dkouidis/Oven-Control-Monitoring-System-Aristurlte/Aristurtle_Oven.pdf

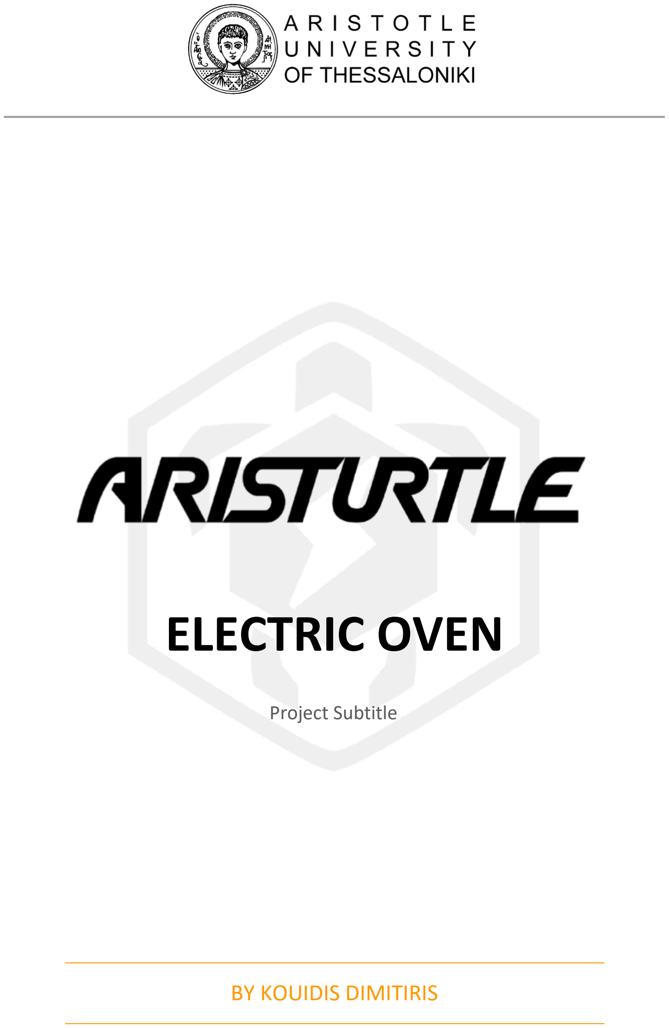
[picture p1: page 1]

# ELECTRIC OVEN

Project Subtitle

### BY KOUIDIS DIMITIRIS

Page 2 of 23

### Table of Contents

Table of Contents | 2
Introduction | 3
1. | HARDWARE | 4
| 1.1 Zero-Volt Cross Detection Circuitry | 4
| 1.2 Phase Control | 6
| 1.3 Temperature Reading | 7
| 1.4 Hall sensor | 7
2. | Peripherals | 8
| 2.1 LCD Display | 8
| 2.2 Thermocouples | 8
| 2.3 Potentiometer | 8
| 2.4 Digital Temperature Sensors | 8
| 2.5 Safety Digital Temperature Sensor | 9
3. | Control System | 10
| 3.1 Brief to PI control | 10
| 3.2 Esp32 | 11
4.Temporary implementation | 12
5. Test and suggestions | 22
Sources – References | 23

Page 3 of 23

## Introduction

This year we decided to re-manufacture the external electric oven that operates with a PI control in combination with a phase control system. This decision was made after noticing that the previous system could not keep the temperature close to the desired one and the declinations during the function of the oven were large, while the mechanical team was not able to use the smaller oven located on the Oikiskos B for everything they needed.

To provide a solution to this problem, we reconstructed the oven from scratch, we designed a new PCB using a better version of the Zero Cross Detection circuitry and added some extra safety features.

This booklet’s purpose is to explain the basic functions of the electric oven, providing explanations of the circuits used in the PCB, the software used and the
improvements that can be made.

By the time this booklet is being written, there is no software implementation for the actual PCB but software for a “version” of it as the time was limited and we implement a faster, maybe not so reliable, solution. The booklet contains both the current implementation and the “correct” one.

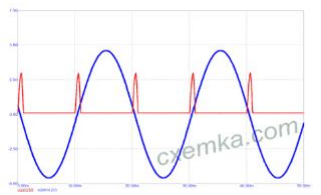
[picture p2: figure]
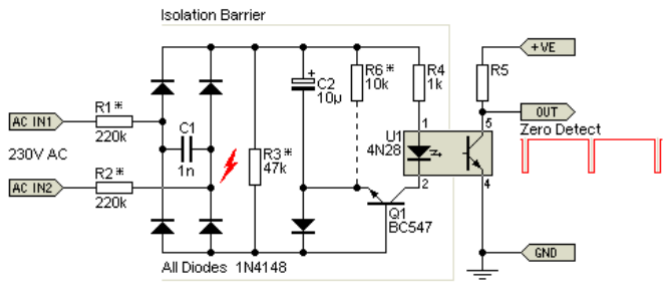
[picture p3: figure]

Page 4 of 23

## 1. HARDWARE

1.1 Zero-Volt Cross Detection Circuitry

As shown on the image below, we want to detect the times that the alternating voltage passes the 0V point and each time it does send a signal/pulse to our microcontroller. With blue we represent the alternating voltage and with red the pulses.

To achieve this, we needed to find a circuit that does this exact thing, while degrading the voltage from 220V to a value much smaller.

Page 5 of 23

The above circuit was found online and tested before deciding whether to use it or not. During the tests we noticed that the results were satisfactory and better than the previous implementation for the detections of the zero cross.

You can find the analytical description of the circuitry in the Sources-References chapter on links [5] and [6].

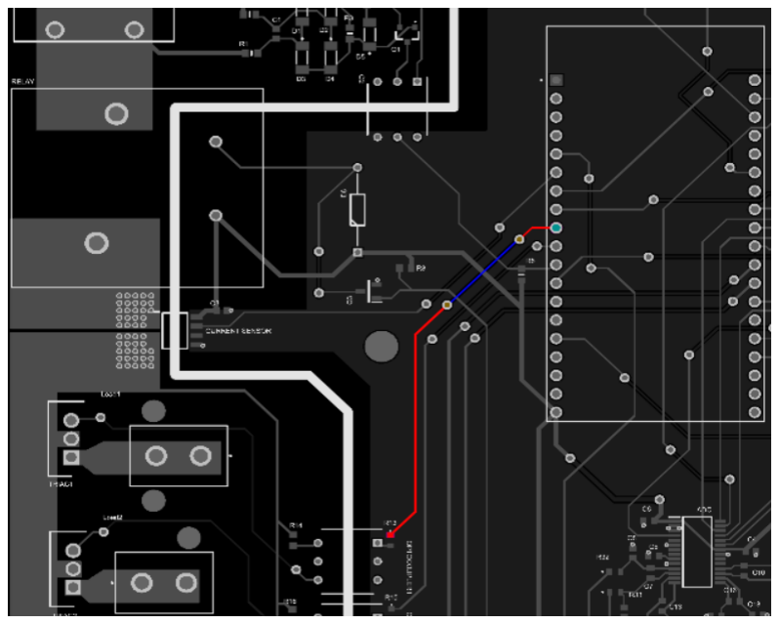
[picture p4: figure]
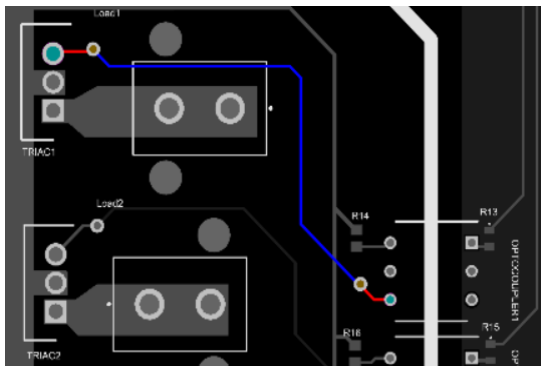
[picture p5: figure]

Page 6 of 23

1.2 Phase Control

After the zero-volt cross detection the pi controller, implemented with the esp32, decides when the firing pulse will be sent. To achieve the desired load, we use four optocouplers, so we need four firing pulses. The firing pulses are being sent by some pins of the esp32. Each of these pins are connected to an optocoupler. We need the optocoupler for isolation between the esp32 and the triacs. The outlet of each optocoupler is connected with the trigger gate of one triac and in that way the triac receives the triggering pulse of the esp32, and it conducts.

Page 7 of 23

1.3 Temperature Reading

In addition to the improvement of the zero-volt cross detection circuit, we decided to improve the measurement of the oven’s internal temperature by using four thermocouples. To read their values we use an ADC compatible with the SPI protocol. Each thermocouple is placed on one of the edges of the oven and with the ADC we alternate the readings between them every few milliseconds. By that way we can calculate the average temperature of the four thermocouples and have a clear view of the setup’s function

1.4 Hall sensor

For safety reasons we decided to add a Hall sensor to measure the current flowing through the triacs. The sensor sends the measurement to esp32 and can be printed on the Serial Monitor or shown on the LCD Display, according to your preferences.

Page 8 of 23

## 2. Peripherals

2.1 LCD Display
As a display we used a 16×2 LCD display that interfaces with I2C protocol. On the LCD we display the current temperature and the target. The LCD holds four pins, one for 5V, one for ground (GND) and two for communication. These are the SDA and SCL pins which need to be connected to 21 and 22 pins of the esp32 respectively.

2.2 Thermocouples
A thermocouple is an electrical device consisting of two dissimilar electrical conductors (https://en.wikipedia.org/wiki/Electrical_conductor) forming an electrical junction. (https://en.wikipedia.org/wiki/Electrical_junction) A thermocouple produces a temperature dependent voltage (https://en.wikipedia.org/wiki/Voltage) as a result of the Seebeck effect, (https://en.wikipedia.org/wiki/Seebeck_effect) and this voltage can be interpreted to measure temperature. (https://en.wikipedia.org/wiki/Temperature) We use four thermocouples each connected to the ADC.

2.3 Potentiometer
The potentiometer is used to set the desired temperature for the oven to avoid having to change the value in the code and upload it every time a change is needed.

2.4 Digital Temperature Sensors
Apart from the thermocouples the setup supports up to four digital temperature sensors in order to verify the measurements that we get from the thermocouples. Each sensor has its own mini-PCB (which contains also a capacitor) to facilitate the connection with the main PCB. The sensors support the SPI protocol so we can alternate the readings between them and the ADC.

Notice that there is a code implementation with a digital sensor, the code of which you can find in the team’s Gitlab on the unity “Little Oven”.

Page 9 of 23

2.5 Safety Digital Temperature Sensor
Another programmable temperature sensor is being used for safety reasons. If the temperature of the oven exceeds a certain large value (in case of malfunction) it triggers a Normally Open relay and it stops the power supply of the triacs. The sensor has its own mini-PCB (which includes three resistors and a capacitor) as well.

Page 10 of 23

## 3. Control System

3.1 Brief to PI control

A proportional–integral controller (PI controller) is a control loop mechanism employing feedback that is widely used in industrial control systems and a variety of other applications requiring continuously modulated control. A PI controller continuously calculates an error value e(t) as the difference between a desired setpoint and a measured process variable and applies a correction based on proportional and integral terms (denoted P and I respectively).

→ Term P is proportional to the error e(t). For example, if the error is large and positive, the control output will be proportionately large and positive, considering the gain factor "K". Using proportional control alone will result in an error between the setpoint and the actual process value, because it requires an error to generate the proportional response. If there is no error, there is no corrective response.

→ Term I accounts for past values of the error and integrates them over time to produce the I term. For example, if there is a residual error after the application of proportional control, the integral term seeks to eliminate the residual error by adding a control effect due to the historic cumulative value of the error. When the error is eliminated, the integral term will cease to grow. This will result in the proportional effect diminishing as the error decreases, but this is compensated for by the growing integral effect.

Tuning

The balance of these effects is achieved by loop tuning to produce the optimal control function. The tuning constants are shown below as "K" and must be derived for each control application, as they depend on the response characteristics of the complete loop external to the controller. These are dependent on the behavior of the measuring sensor, the final control element, any control signal delays and the process itself.

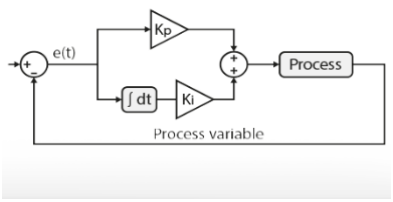
[picture p6: figure]

Page 11 of 23

Notice that for the further improvement of the setup, a Term D (derivative) can be added to the control (PID controller).

3.2 Esp32
We used an esp32-devkitC to implement PI control and the interface with the user. The last one includes the LCD display and the potentiometer.

The basic functions of the esp32 are:

- Read the desired temperature through the potentiometer
- Read the temperature through the ADC
- Read the current value through the hall sensor
- Detect the zero-volt cross
- Execute PI control to reach the desired temperature
- Print the real, the desired temperature and the error to the display

Page 12 of 23

## 4.Temporary implementation

As mentioned at the beginning the code for all the above functionalities is non-existent. Below is described the existing code which the team used during the 2024-2025 season.

💢Thermistor

The thermistor we use is an NTC thermistor with a nominal resistance of 100kΩ. Thermistors are temperature-sensing elements made of semiconductor material that has been sintered to display large changes in resistance in proportion to small changes in temperature. This resistance can be measured by using a small and measured direct current, or dc, passed through the thermistor to measure the voltage drop produced. NTC Thermistors are non-linear resistors, which alter their resistance characteristics with temperature. The resistance of NTC will decrease as the temperature increases. The way the resistance decreases is related to a constant known in the electronics industry as beta, or β. Beta is measured in °K.

Before we convert the resistance of the thermistor to the respective temperature, we need to measure its resistance. For this purpose, we must turn the esp32 into an ohmmeter. First, we connected a resistor in series with the thermistor. This resistor should have the same resistance as the nominal resistance of the thermistor for better accuracy. This addition occurred under the connectors which would be used, under normal circumstances, for the external digital temperature sensors. We also added a decoupling capacitor for noise reduction.

So, we needed to define the resistor we used in series with the thermistor, the nominal resistance of the thermistor, the reference temperature and the b coefficient of our thermistor. We also initialize some other variables for the calculation of the temperature.

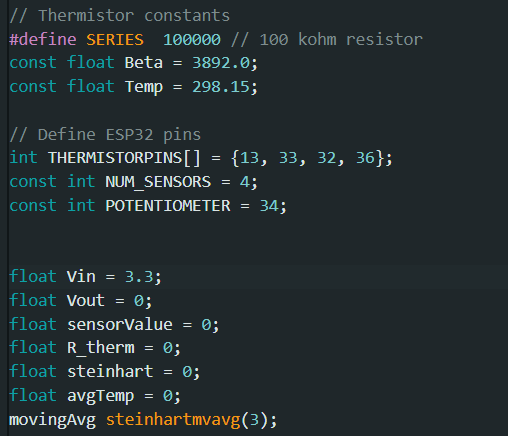
[picture p7: figure]

Page 13 of 23

The calculation of the temperature is implemented inside the function read_average_temperature(). The first step is to read the analog value from the pins of the esp32 that the thermistors are connected to and convert it to volts. Provided that we know the voltage on the thermistor, the Vin and the resistor in series with the thermistor we can calculate their resistance. At the end we calculate the average temperature.

During operation we noticed that sometimes the values from the first 2 pins were correct while 2 were not. That happened probably from some bad connections to the wire because after a point everything worked properly. However, we implemented a “check” for the values of the last 2 pins according to the measurements of the first 2. If the decline of the values is less than a threshold they are being considered, if there is more, then they are skipped.

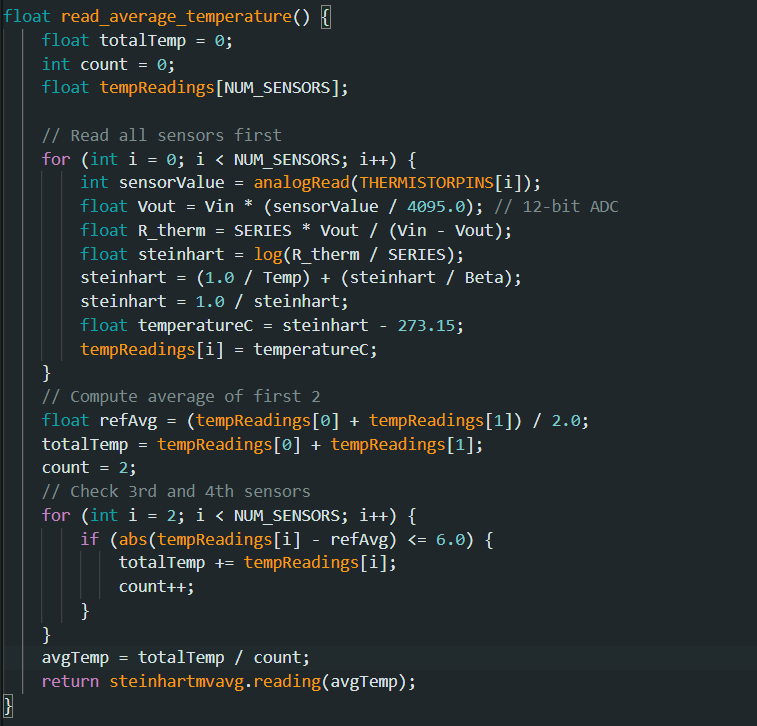
[picture p8: figure]

Page 14 of 23

💢 Zero-Volt Cross

At the beginning we define the pin where the output from the zero-volt cross detection circuit will be written and the pins which will “send” the pulse to the optocouplers. We also define a boolean value which turns to “1” when a zero-volt cross is detected to help us handle the interrupt we are using for this purpose.

Page 15 of 23

Below is provided the interrupt handler. In other words when the zcd pin goes to LOW (according to our circuit zcd is always HIGH and is pulled down when a zero cross is detected) and the error is bigger than zero then we allow the pulses from the angleControl pins to be sent to the optocouplers so that the triacs will conduct. We will explain this in more detail below.

💢 PI implementation

Continuing from the ZCD, let’s see how we handle PI control. Firstly, we declare the values of the variables used to calculate the PI output at each state. The PI output (variable “pi”) is the value which determines for how long the angleControl pins will be set as HIGH --> how many amperes will conduct through the triacs. To calculate its value, we use the formula pi = error * Kp + previous_error * Ki as can be seen below.

After manual testing, we found that Kp = 200 and Ki = 20 will give the best results for our implementation.

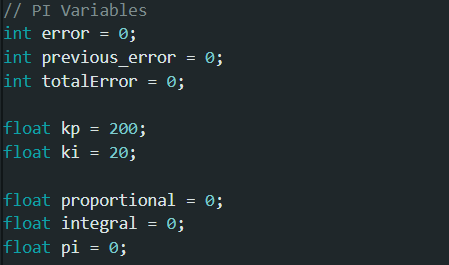
[picture p9: figure]
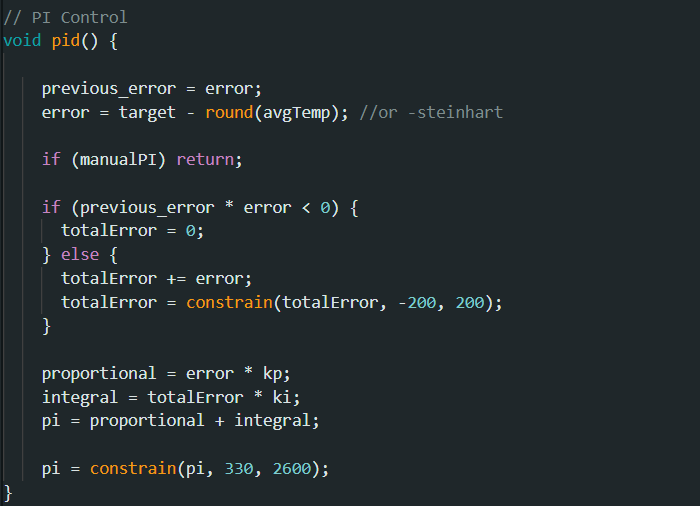
[picture p10: figure]

Page 16 of 23

To not burn the triacs, we must set constraints on the pi variable. In the PCB placed on Oikiskos B at this time, there were problems with two of the four triacs and they didn’t conduct. After hours of debugging, we could not find what was wrong. So, we supplied the four resistors from the two triacs. Having a maximum rating of 10A, after manual testing, we found out that the upper limit of pi must be 2600. Under normal circumstances and if all triacs are working properly this upper limit can be exceeded, while there is no limitation for the lower boundary. We strongly recommend that before setting the upper limit to manually test with an amperemeter the load and slightly increase it.

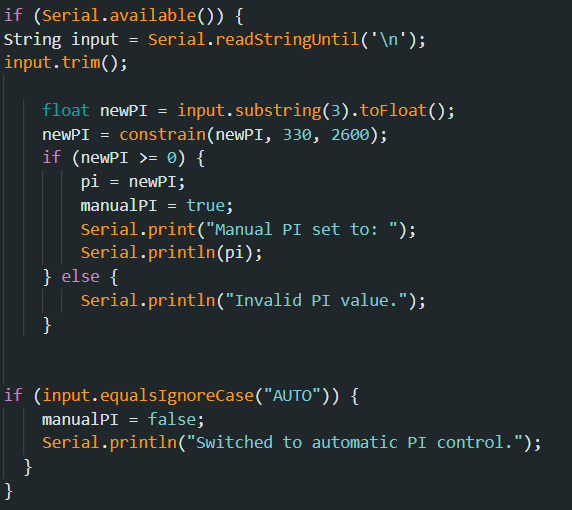
[picture p11: figure]

Page 17 of 23

To gradually increase the upper boundary, we have implemented a feature where you can change manually the PI output by writing on the Serial Monitor “PI= “and the value you want to set.

To switch back to the automatic PI control just type “AUTO”.

Below you can see how we enable the conduction of the triacs. The delay of 9700-pi us means that when the pi variable is big (== the error is big), the delay will be shorter so the triacs will conduct for a larger duration of the voltage half-cycle.

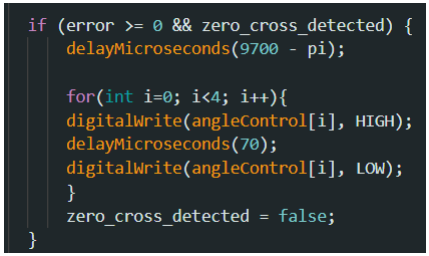
[picture p12: figure]
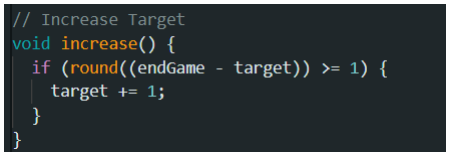
[picture p13: figure]

Page 18 of 23

💢 Target and endGame variables

The target variable starts from the value “10” and increases every 1.5 seconds until it reaches the value of endGame. That happens so the error is gradually increased, and the system follows a ramp approach.

The endGame value represents the desired temperature we want to achieve inside the oven.

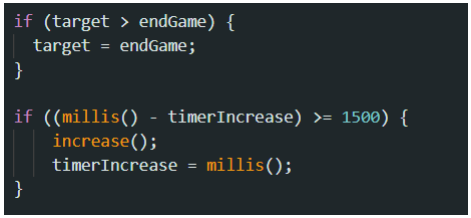
[picture p14: figure]

Page 19 of 23

💢 LCD display

The LCD displays the current and the desirable temperature, the target value as it increases and the error value. The code we use to achieve that is implemented inside the function monitor() which is called inside the loop every second.

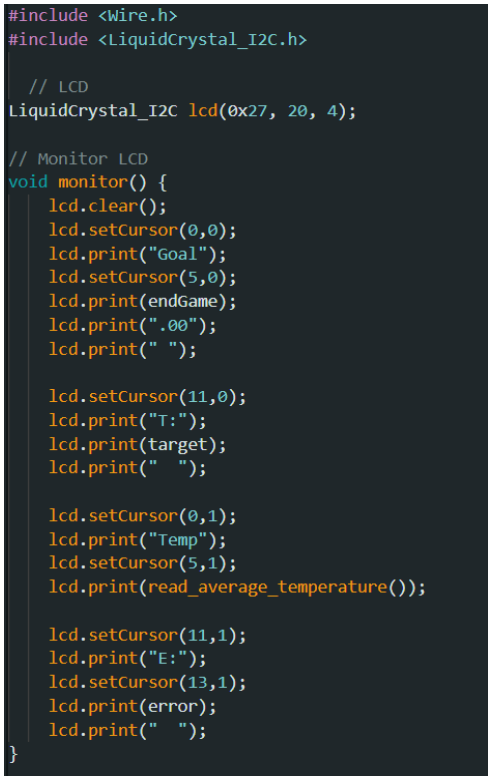
[picture p15: figure]

Page 20 of 23

💢 Potentiometer

All we need to obtain the desired temperature from the user are two variables, one to load the value that the analogRead() function returns and one to load the target temperature after we map, with the help of the map() function, the value from the analog input to 20-100°C. Also, we added a constraint just to make sure that the value will never exceed 100°C.

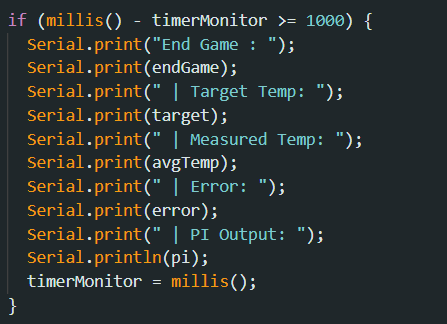
[picture p16: figure]

Page 21 of 23

💢 Serial Monitor

Finally, for debugging purposes, we added some prints to the Serial Monitor, like the ones that are depicted on the LCD display, plus the PI output. These messages are printed every second when you connect your laptop to the esp32 and can function as an alternative to the LCD if something goes wrong (i.e. the display malfunctions).

Page 22 of 23

## 5. Test and suggestions

To test the functionality of the PCB we check the following things by using an oscilloscope:

1. The output of the zero-volt cross circuit
2. The pulses from the angleControl pins
3. The pulses on the optocouplers on the LV side and the trigger signals on the HV side to the triac

After noticing that all the results were the expected, we supplied the PCB with the 220V and measured the output current from each triac with an amperemeter.

At first everything worked perfectly, but after some time, two triacs stopped being conducted. So, as it is reported above, we used only the two functional triacs and decreased the upper limit of the pi variable.

Finally, we think by reading this booklet you will have a brief idea of what should be done to optimize this project. Anything else you need to add, like peripherals, or some engineering you need to do to make the control to fit your specifications, well… that’s up to you.

Page 23 of 23

## Sources – References

1. https://aristotle-university-racing-team-electric-aristurtle-2.365.altium.com/designs/59F2FFF9-056E-4E07-A582-B7CE4B444313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[No+Variations]&location=[1,101.46,19.05,14.08]#design (https://aristotle-university-racing-team-electric-aristurtle-2.365.altium.com/designs/59F2FFF9-056E-4E07-A582-B7CE4B444313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)
2. https://gitlab.com/aristurtle/electrical/oven
3. https://en.wikipedia.org/wiki/Thermocouple
4. https://eepower.com/resistor-guide/resistor-types/ntc-thermistor/
5. https://sound-au.com/appnotes/an005.htm
6. https://dextrel.net/dextrel-start-page/design-ideas-2/mains-zero-crossing-detector (https://dextrel.net/dextrel-start-page/design-ideas-2/mains-zero-crossing-detector)
