dkouidis/Oven-Control-Monitoring-System-Aristurlte/Oven_Casing/Oven_Case.SLDPRT

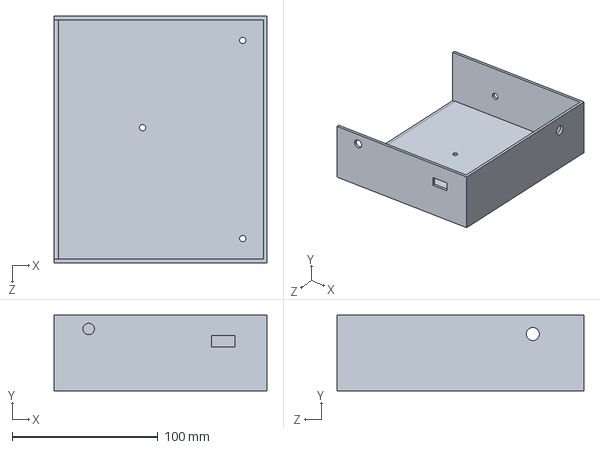
[picture p17: CAD file, 2026-09-28]
Oven_Casing/Oven_Case.SLDPRT
146.0 x 52.0 x 169.1 mm
