dkouidis/Oven-Control-Monitoring-System-Aristurlte/(list of files, drawings)

Other design files:
Oven_PCB/ESP32-DEVKITC-32D.SchLib
Oven_PCB/MODULE_ESP32-DEVKITC-32D.PcbLib
Oven_PCB/oven_v1.PrjPcb
Oven_PCB/PCB1.PcbDoc
Oven_PCB/PCB_Libraries.PcbLib
Oven_PCB/PR27-5V-S-900-1A-EF.SchLib
Oven_PCB/RELAY_PR27-5V-S-900-1A-EF.PcbLib
Oven_PCB/Schematic_Libraries.SchLib
Oven_PCB/Sheet1.SchDoc
